craftvia/craftvia-core-s-g031/docs/SCH_Core-S-G031-Rev0_2026-09-30.pdf

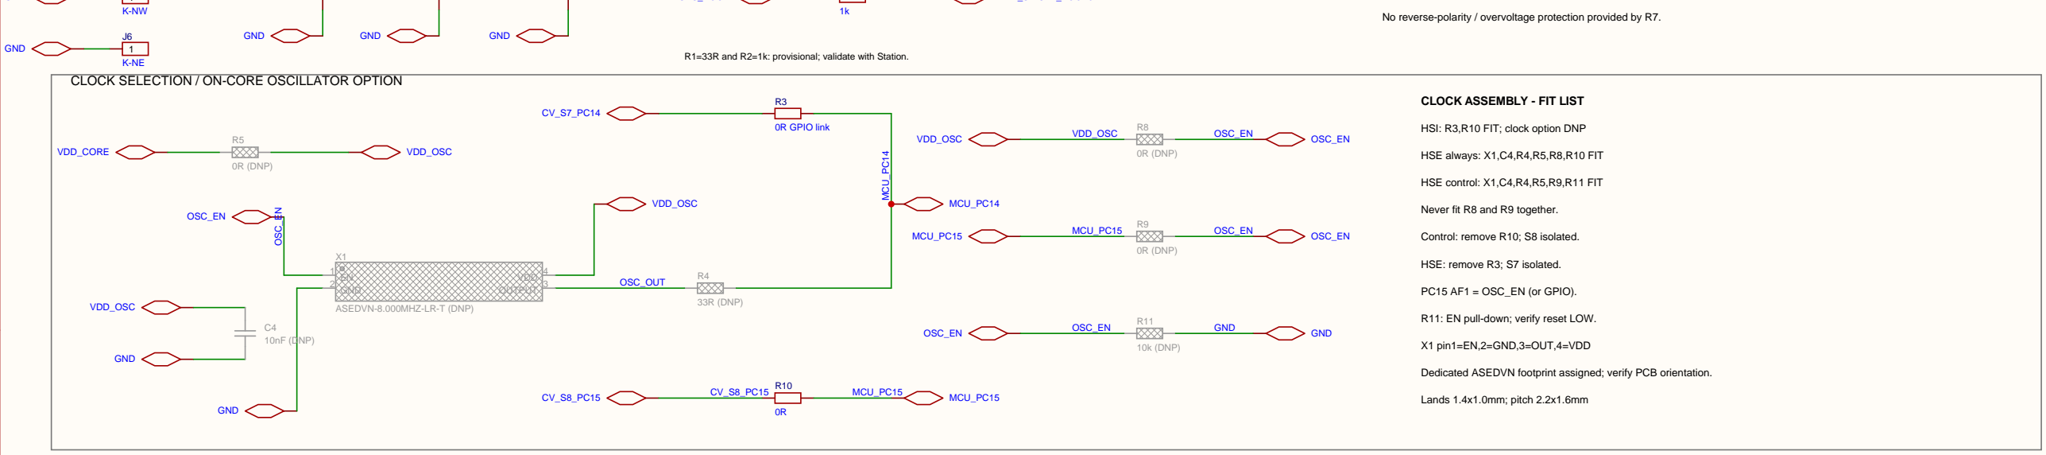
[picture p2: figure]
GND; 0R GPIO link; 33R (DNP); 0R (DNP); MCU_PC14; VDD_CORE; VDD_OSC; OSC_EN; OSC_OUT; C4 10nF (DNP); OSC_EN VDD_OSC; MCU_PC15; OSC_EN MCU_PC15; 10k (DNP); GND OSC_EN; HSI: R3,R10 FIT; clock option DNP; HSE always: X1,C4,R4,R5,R8,R10 FIT; HSE control: X1,C4,R4,R5,R9,R11 FIT; Never fit R8 and R9 together.; Control: remove R10; S8 isolated.; HSE: remove R3; S7 isolated.; PC15 AF1 = OSC_EN (or GPIO).; R11: EN pull-down; verify reset LOW.; X1 pin1=EN,2=GND,3=OUT,4=VDD; Lands 1.4x1.0mm; pitch 2.2x1.6mm; EN 1 GND 2; OUTPUT 3; VDD 4; ASEDVN-8.000MHZ-LR-T (DNP); CLOCK ASSEMBLY - FIT LIST

Schematic | Core-S-G031-Rev0 | Create at | 2026-09-03
| | Update at | 2026-09-29
Board | Board1 | Page | Core-G031
Drawn | | CraftVia-Core-S-G031-v1-Rev0

# Reviewed

Version | Size | Page 1 Total 1
V1.0 | A3 | CraftVia,org

PB9 1
PC14-OSC32IN 2
PC15-OSC32OUT 3
VDD/VDDA 4
VSS/VSSA 5
PF2-NRST 6
PA0 7
PA1 8
PA2 9
PA3 10
PA4 11
PA5 12
PA6 13
PA7 14
PB0 15
PB1 16 | PB2 17 PA8 18 PA9 19 PC6 20 PA10 21 PA11[PA9] 22 PA12[PA10] 23 PA13 24 PA14-BOOT0 25 PA15 26 PB3 27 PB4 28 PB5 29 PB6 30 PB7 31 PB8 32

U1

STM32G031K8T6

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
N 1-8

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
E 1-8

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
S 1-8

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
W 1-8

1

J5

1

J7

K-SW

100nF

C1 | C2
4.7uF | 100nF

C3

R1

33R

R2

SYS_NRST
SYS_SWDIO
SYS_SWCLK
SYS_BOOT
CV_N5_PA11
CV_N6_PA12
CV_N7_PB8

CV_E1_PA0
CV_E2_PA1
CV_E3_PA2
CV_E4_PA3
CV_E5_PA4
CV_E6_PA5
CV_E7_PA6
CV_E8_PA7

CV_S1_PA8
CV_S2_PB0
CV_S3_PB1
CV_S4_PC6
CV_S5_PB2
CV_S6_PB9
CV_S7_PC14
CV_S8_PC15

CV_W1_PA9
CV_W2_PA10
CV_W3_PB6
CV_W4_PB7
CV_W5_PB3
CV_W6_PB4
CV_W7_PB5
CV_W8_PA15

CV_S6_PB9

MCU_PC15
VDD_CORE
GND
SYS_NRST
CV_E1_PA0
CV_E2_PA1
CV_E3_PA2
CV_E4_PA3
CV_E5_PA4
CV_E6_PA5
CV_E7_PA6
CV_E8_PA7
CV_S2_PB0
CV_S3_PB1 | CV_S5_PB2 CV_S1_PA8

CV_W1_PA9

CV_S4_PC6

CV_W2_PA10

CV_N5_PA11

CV_N6_PA12

SYS_SWDIO

PA14_SWCLK_BOOT0

CV_W8_PA15

CV_W5_PB3

CV_W6_PB4

CV_W7_PB5

CV_W3_PB6

CV_W4_PB7

CV_N7_PB8

GND

+3V3

VDD_CORE

VDD_CORE

SYS_NRST | SYS_SWCLK | PA14_SWCLK_BOOT0
SYS_BOOT | PA14_SWCLK_BOOT0

1

TP1

| VTREF | 1 TP2
GND | 1

TP3
SWDIO | 1

TP4
SWCLK | 1

TP5
NRST
VDD_CORE | GND | SYS_SWDIO

PA14_SWCLK_BOOT0

### SYS_NRST NORTH / J1.1-8 = N1-N8

### SOUTH / J3.1-8 = S1-S8

### MCU / STM32G031K8T6

KEY / POWER | SWCLK / BOOT0 SHARED PIN

### DESIGN NOTES - NOT RELEASED FOR FABRICATION

J1-J4: 2.54 mm headers; J5/J6=GND, J7=3V3.
Header height and TP bare-pad footprints: to be finalized. SYS_BOOT: High-Z normally; disconnect SWCLK for BOOT. R1/R2 do not provide SWCLK/BOOT electrical isolation. BOOT option bytes and reset timing require validation. C1/C2 close to U1 supply. PC14/15: restricted I/O drive. Common contact positions: see Core-S series specification.

MCU_PC14

## CLOCK SELECTION / ON-CORE OSCILLATOR OPTION

Validate startup, clock switching, EN LOW and current on hardware.

R6

10k (DNP)

R7

0R / FB option

+3V3 | VDD_CORE
VDD_CORE | SYS_NRST

## POWER FILTER / RESET OPTIONS

R7: FIT 0R by default; replace with qualified 0603 ferrite only.

C1/C2, U1, TP1 and oscillator supply are downstream of R7.

Check bead DCR/current, voltage drop and LC resonance.

R6: optional NRST pull-up, 10k / 0603, DNP by default.

Internal pull-up + existing C3 remain. Validate reset timing.

No reverse-polarity / overvoltage protection provided by R7.

# CraftVia Core-S G031 | v1 Rev0 - SCHEMATIC DRAFT

### EAST / J2.1-8 = E1-E8

### WEST / J4.1-8 = W1-W8

### SWD rescue access (TP footprint provisional)

### DECOUPLING / RESET

R1=33R and R2=1k: provisional; validate with Station.

## CLOCK OPTION - DESIGN NOTES

X1: ASEDVN-8.000MHZ-LR-T / 8 MHz CMOS.

Standard: internal HSI; external oscillator is optional.

Power OFF before changing links; match firmware to assembly.

External clock: HSE bypass, 8 MHz; disconnect S7 via R3.

Do not drive PC14 as GPIO with the external clock fitted.

Enable: R8 always ON, or R9 from PC15; never fit both.

Place X1 near PC14, C4 at X1 supply, R4 near X1 OUT.

Disable uses EN; supply remains connected. No LSE crystal.

Dedicated ASEDVN footprint assigned; verify PCB orientation.

3.3 V input. Internal HSI standard; no regulator / USB / LED.
