craftvia/craftvia-core-s-g031/docs/images/core-s-g031-v1-rev0-front.webp

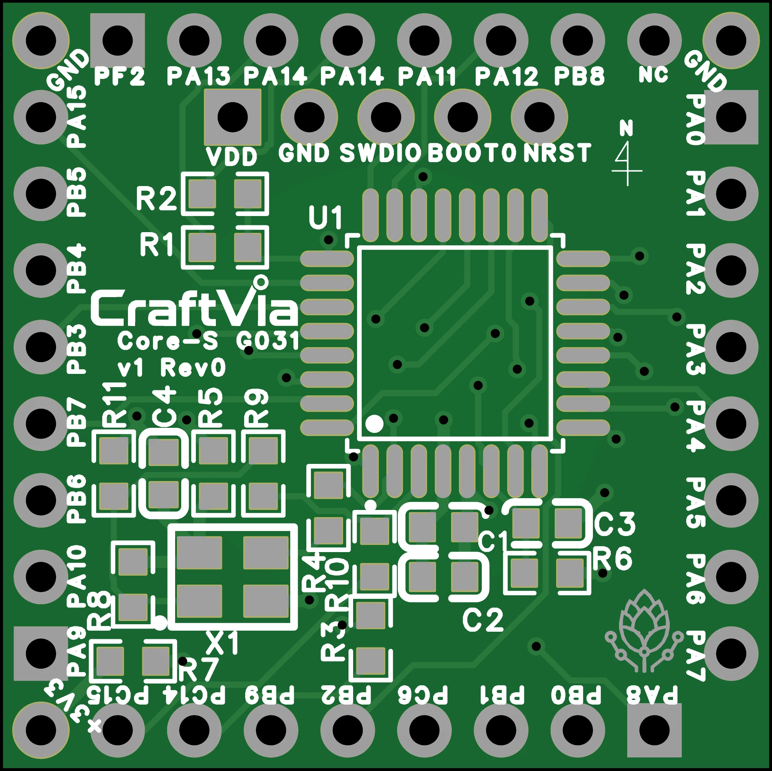
docs/images/core-s-g031-v1-rev0-front.webp
