craftvia/craftvia-core-s-g031/(list of files, drawings)

Other design files:
source/ProPrj_CraftVia-Core-S-G031-v1-Rev0.epro
